Proiect-Krontech/ProiectKrontech/hardware/kicad/components/HX711_mod/HX711_module.jpg

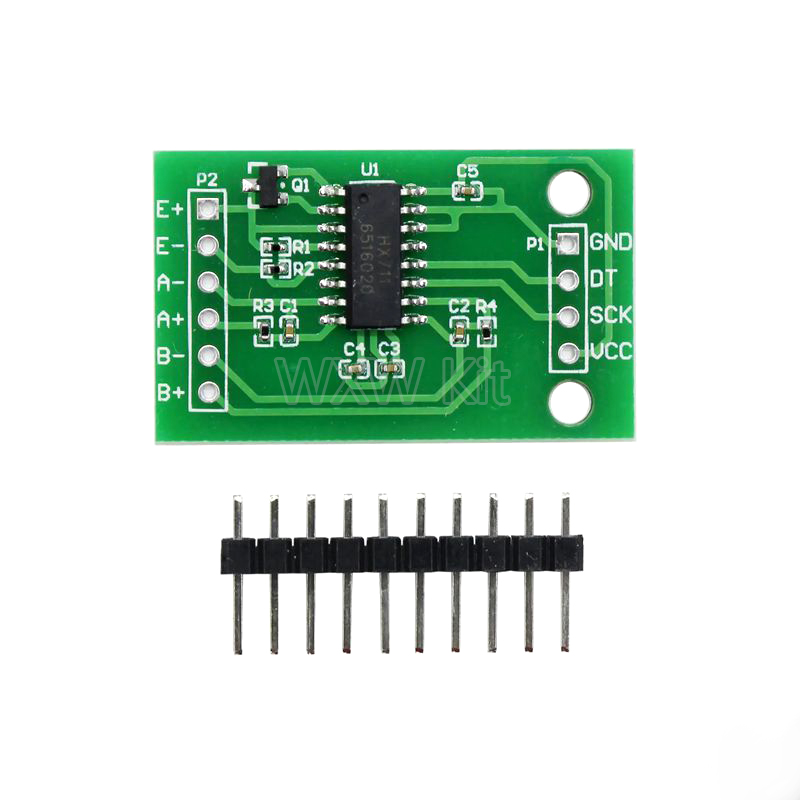
hardware/kicad/components/HX711_mod/HX711_module.jpg
