Proiect-Krontech/ProiectKrontech/docs/smart_pillow_future_3D.png

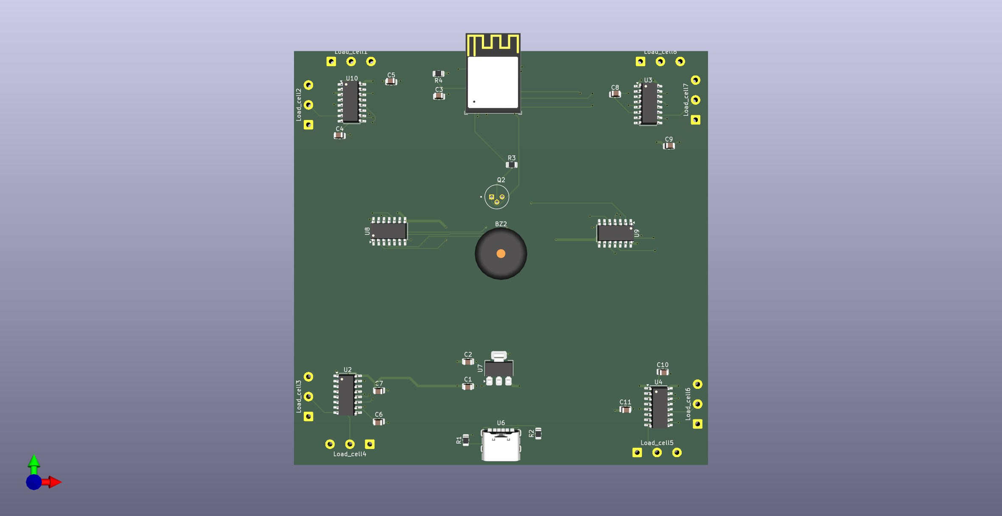
docs/smart_pillow_future_3D.png
