Proiect-Krontech/ProiectKrontech/docs/smart_pillow_future_PCB.png

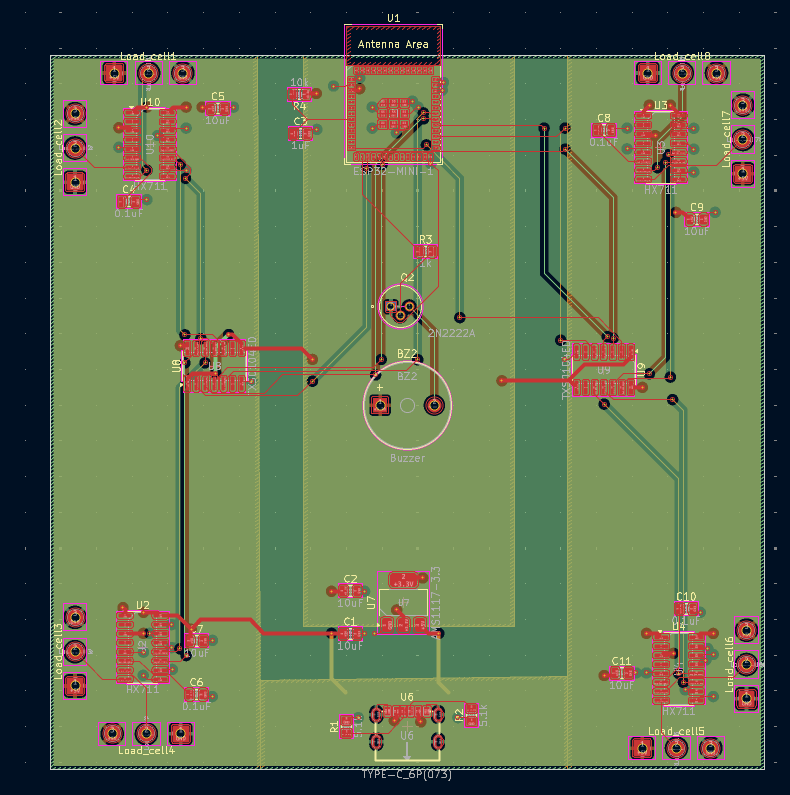
docs/smart_pillow_future_PCB.png
