Proiect-Krontech/ProiectKrontech/hardware/kicad/components/2N2222A/2N2222A.step

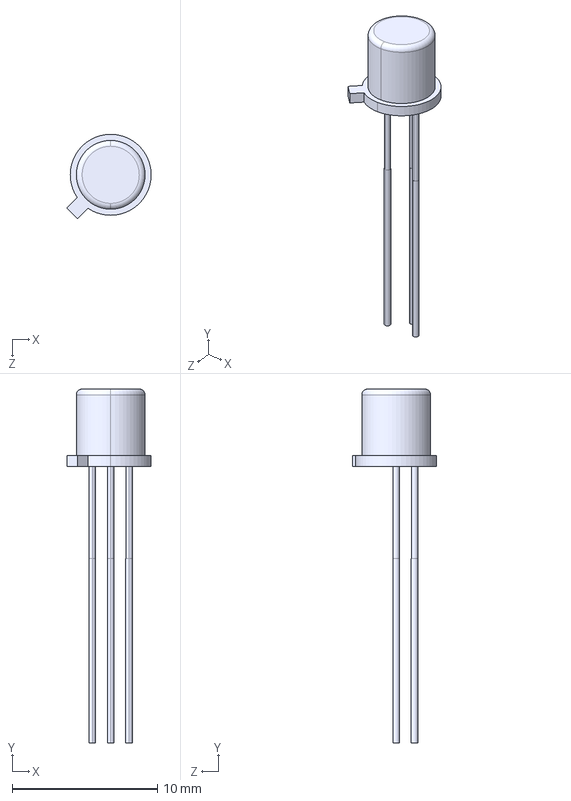
[picture p4: CAD file, 2026-05-10]
hardware/kicad/components/2N2222A/2N2222A.step
5.81 x 24.4 x 5.81 mm
