Proiect-Krontech/ProiectKrontech/docs/design_circuit.pdf

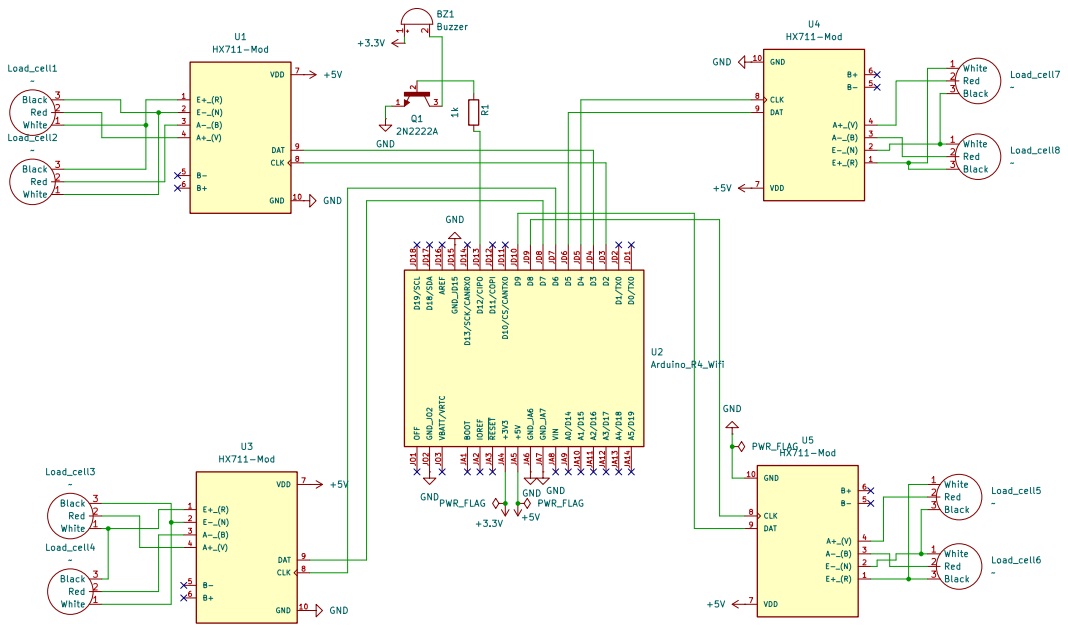
[picture p5: page 1]
