Proiect-Krontech/ProiectKrontech/docs/smart_pillow_future.pdf

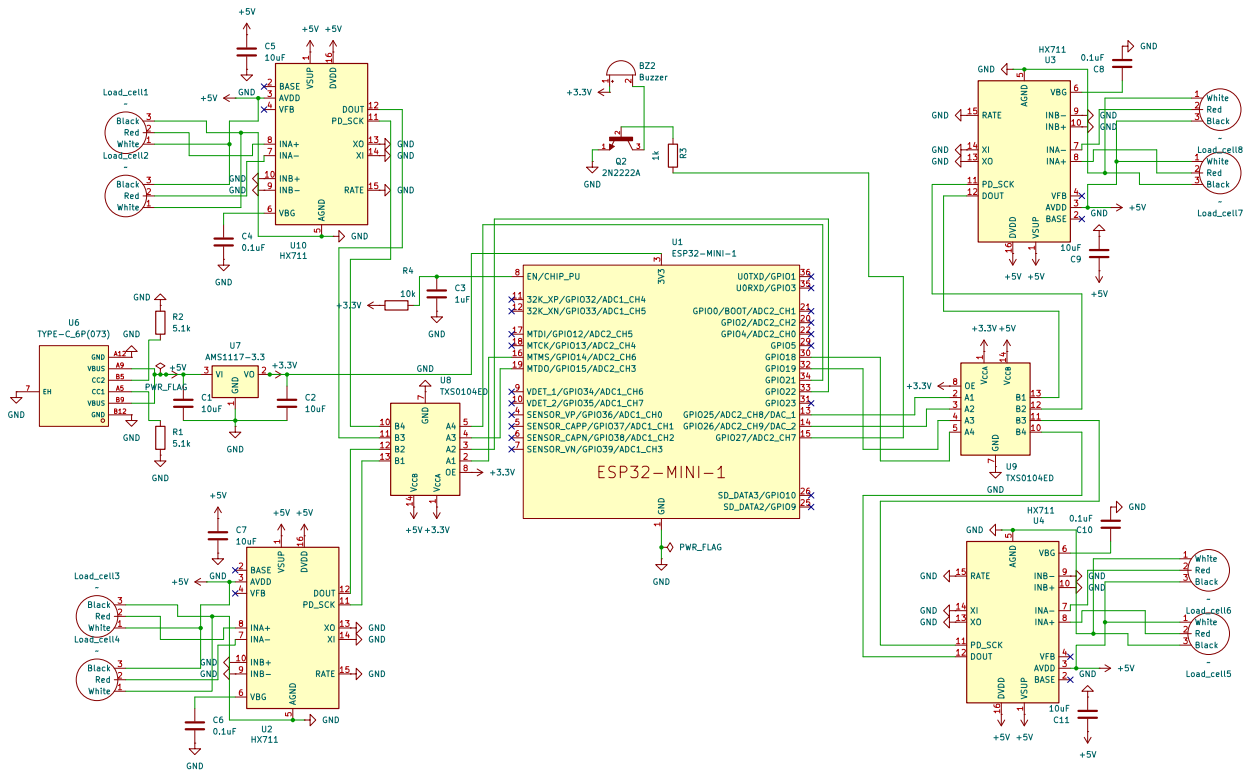
[picture p6: page 1]
