Proiect-Krontech/ProiectKrontech/hardware/future direction/smart_pillow/smart_pillow/smart_pillow.kicad_pcb

## KiCad design hardware/future direction/smart_pillow/smart_pillow/smart_pillow.kicad_pcb (2026-05-15)

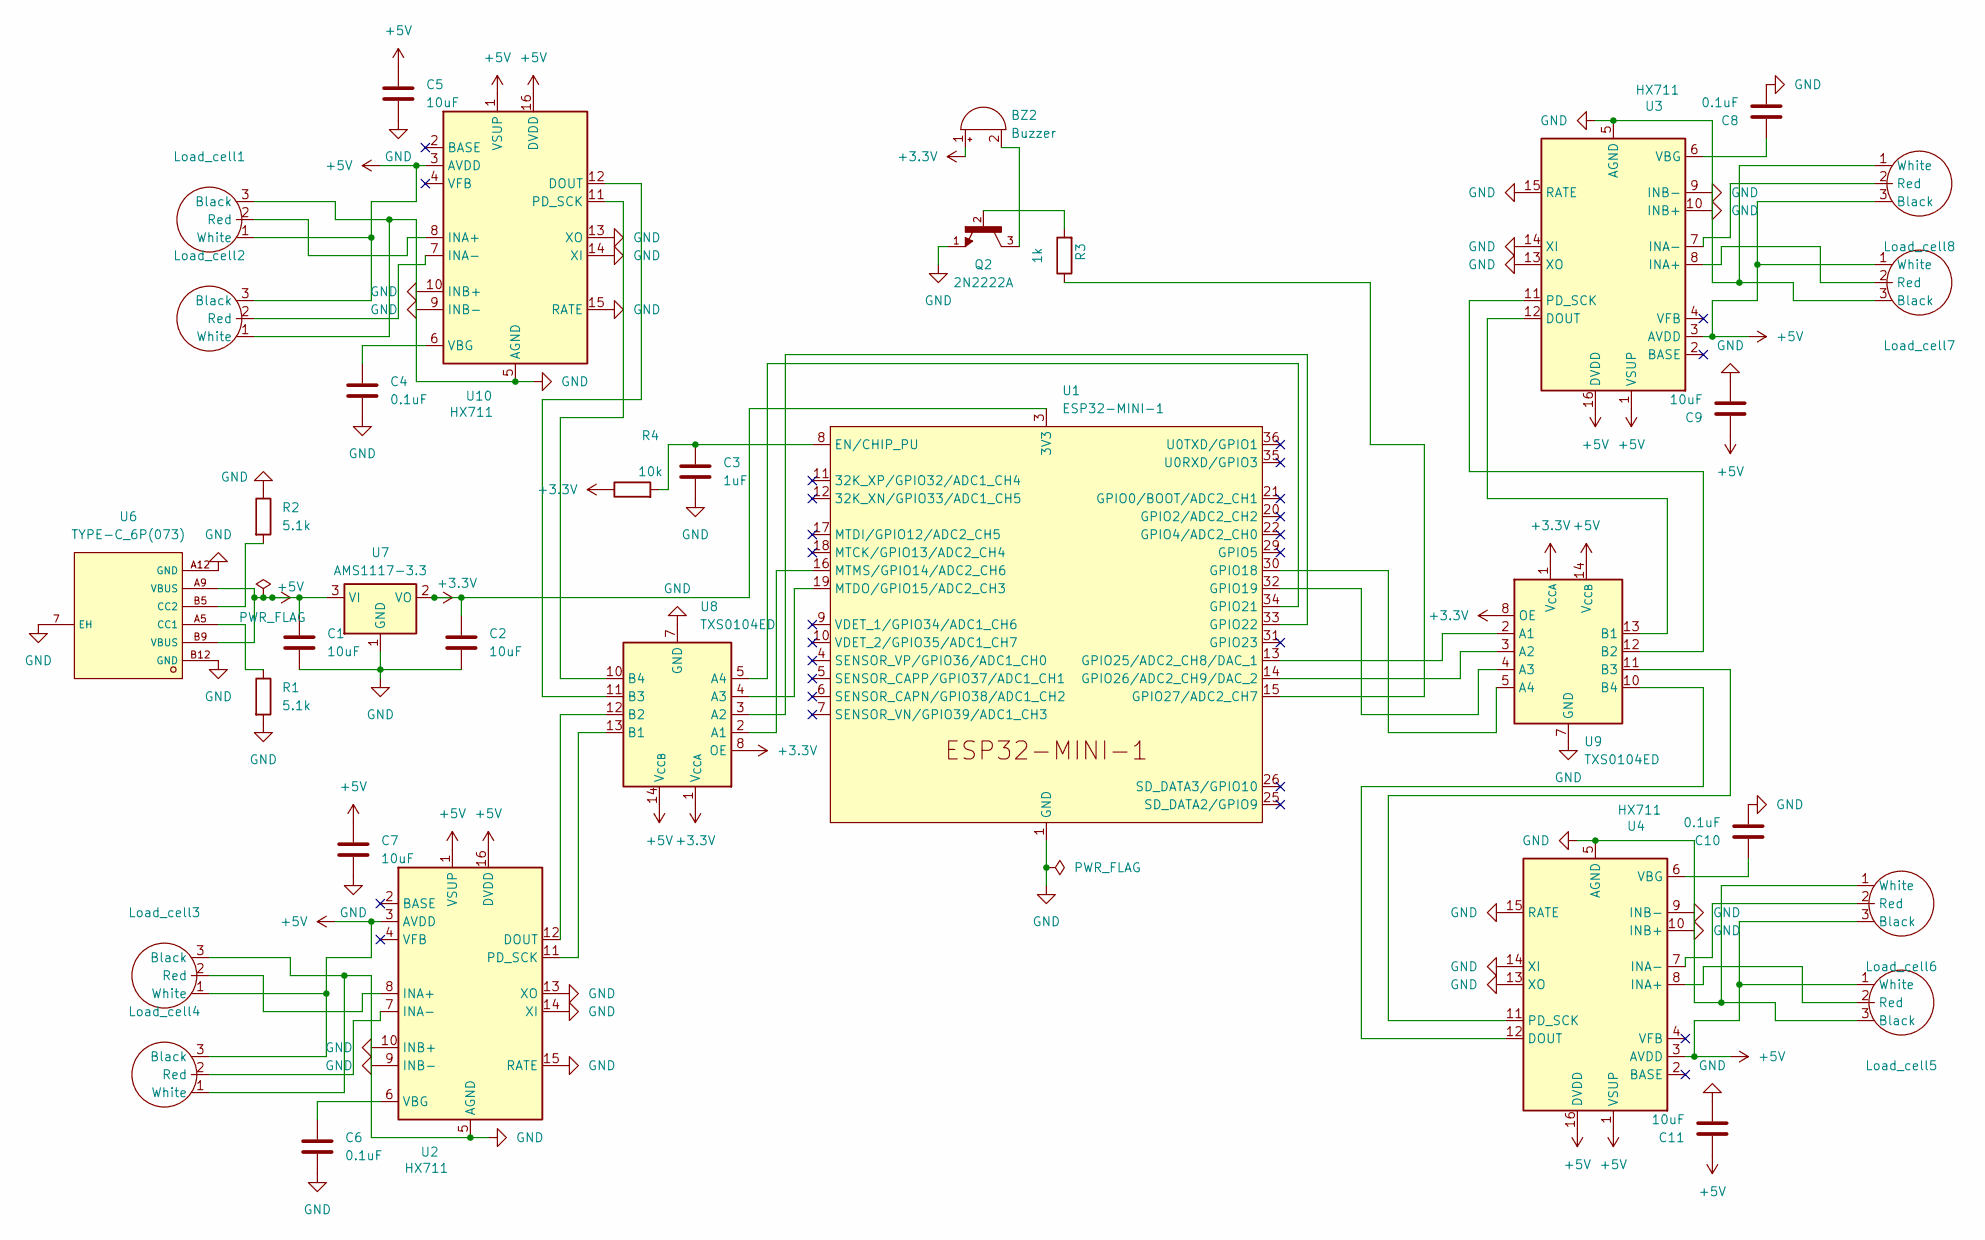
[picture p7: schematic smart_pillow.kicad_sch]

Parts:
BZ2: Buzzer; Buzzer_12x9.5RM7.6
C1, C2, C5, C7, C9, C11: 10uF; C_0805_2012Metric
C3: 1uF; C_0805_2012Metric
C4, C6, C8, C10: 0.1uF; C_0805_2012Metric
Load_cell1, Load_cell2, Load_cell3, Load_cell4, Load_cell5, Load_cell6, Load_cell7, Load_cell8: SolderWire-0.5sqmm_1x03_P4.8mm_D0.9mm_OD2.3mm
Q2: 2N2222A; TO127P584H533-3; PARTREV 2
R1, R2: 5.1k; R_0805_2012Metric
R3: 1k; R_0805_2012Metric
R4: 10k; R_0805_2012Metric
U1: ESP32-MINI-1
U2, U3, U4, U10: HX711; SOIC-16_3.9x9.9mm_P1.27mm
U6: TYPE-C_6P(073); TYPE-C-SMD_TYPE-C-6P-073; LCSC C668623
U7: AMS1117-3.3; SOT-223-3_TabPin2
U8, U9: TXS0104ED; SOIC-14_3.9x8.7mm_P1.27mm

Connections:
+3.3V: BZ2.1 (+), C2.1, R4.1, U1.3 (3V3), U7.2 (VO), U8.1 (V_{CCA}), U8.8 (OE), U9.1 (V_{CCA}), U9.8 (OE)
+5V: C1.1, C5.1, C7.1, C9.1, C11.1, Load_cell1.1 (White), Load_cell2.3 (Black), Load_cell3.1 (White), Load_cell4.3 (Black), Load_cell5.1 (White), Load_cell6.3 (Black), Load_cell7.1 (White), Load_cell8.3 (Black), U2.1 (VSUP), U2.3 (AVDD), U2.16 (DVDD), U3.1 (VSUP), U3.3 (AVDD), U3.16 (DVDD), U4.1 (VSUP), U4.3 (AVDD), U4.16 (DVDD), U6.A9 (VBUS), U6.B9 (VBUS), U7.3 (VI), U8.14 (V_{CCB}), U9.14 (V_{CCB}), U10.1 (VSUP), U10.3 (AVDD), U10.16 (DVDD)
GND: C1.2, C2.2, C3.2, C4.2, C5.2, C6.2, C7.2, C8.2, C9.2, C10.2, C11.2, Load_cell1.3 (Black), Load_cell2.1 (White), Load_cell3.3 (Black), Load_cell4.1 (White), Load_cell5.3 (Black), Load_cell6.1 (White), Load_cell7.3 (Black), Load_cell8.1 (White), Q2.1, R1.2, R2.1, U1.1 (GND), U1.2 (GND), U1.27 (GND), U1.38 (GND), U1.39 (GND), U1.40 (GND), U1.41 (GND), U1.42 (GND), U1.43 (GND), U1.44 (GND), U1.45 (GND), U1.46 (GND), U1.47 (GND), U1.48 (GND), U1.49 (GND), U1.50 (GND), U1.51 (GND), U1.52 (GND), U1.53 (GND), U1.54 (GND), U1.55 (GND), U2.5 (AGND), U2.9 (INB-), U2.10 (INB+), U2.13 (XO), U2.14 (XI), U2.15 (RATE), U3.5 (AGND), U3.9 (INB-), U3.10 (INB+), U3.13 (XO), U3.14 (XI), U3.15 (RATE), U4.5 (AGND), U4.9 (INB-), U4.10 (INB+), U4.13 (XO), U4.14 (XI), U4.15 (RATE), U6.7 (EH), U6.A12 (GND), U6.B12 (GND), U7.1 (GND), U8.7 (GND), U9.7 (GND), U10.5 (AGND), U10.9 (INB-), U10.10 (INB+), U10.13 (XO), U10.14 (XI), U10.15 (RATE)
unnamed: BZ2.2 (-), Q2.3
unnamed: Load_cell1.2 (Red), U10.8 (INA+)
unnamed: Load_cell2.2 (Red), U10.7 (INA-)
unnamed: Load_cell3.2 (Red), U2.8 (INA+)
unnamed: Load_cell4.2 (Red), U2.7 (INA-)
unnamed: Load_cell5.2 (Red), U4.8 (INA+)
unnamed: Load_cell6.2 (Red), U4.7 (INA-)
unnamed: Load_cell7.2 (Red), U3.8 (INA+)
unnamed: Load_cell8.2 (Red), U3.7 (INA-)
unnamed: Q2.2, R3.2
unnamed: C3.1, R4.2, U1.8 (EN/CHIP_PU)
unnamed: U1.30 (GPIO18), U9.5 (A4)
unnamed: U1.32 (GPIO19), U9.4 (A3)
unnamed: U1.34 (GPIO21), U8.5 (A4)
unnamed: U1.33 (GPIO22), U8.3 (A2)
unnamed: U1.13 (GPIO25/ADC2_CH8/DAC_1), U9.2 (A1)
unnamed: U1.14 (GPIO26/ADC2_CH9/DAC_2), U9.3 (A2)
unnamed: R3.1, U1.15 (GPIO27/ADC2_CH7)
unnamed: U1.19 (MTDO/GPIO15/ADC2_CH3), U8.4 (A3)
unnamed: U1.16 (MTMS/GPIO14/ADC2_CH6), U8.2 (A1)
unnamed: U2.12 (DOUT), U8.12 (B2)
unnamed: U2.11 (PD_SCK), U8.13 (B1)
unnamed: C6.1, U2.6 (VBG)
unnamed: U3.12 (DOUT), U9.13 (B1)
unnamed: U3.11 (PD_SCK), U9.12 (B2)
unnamed: C8.1, U3.6 (VBG)
unnamed: U4.12 (DOUT), U9.10 (B4)
unnamed: U4.11 (PD_SCK), U9.11 (B3)
unnamed: C10.1, U4.6 (VBG)
unnamed: R1.1, U6.A5 (CC1)
unnamed: R2.2, U6.B5 (CC2)
unnamed: U8.11 (B3), U10.12 (DOUT)
unnamed: U8.10 (B4), U10.11 (PD_SCK)
unnamed: C4.1, U10.6 (VBG)

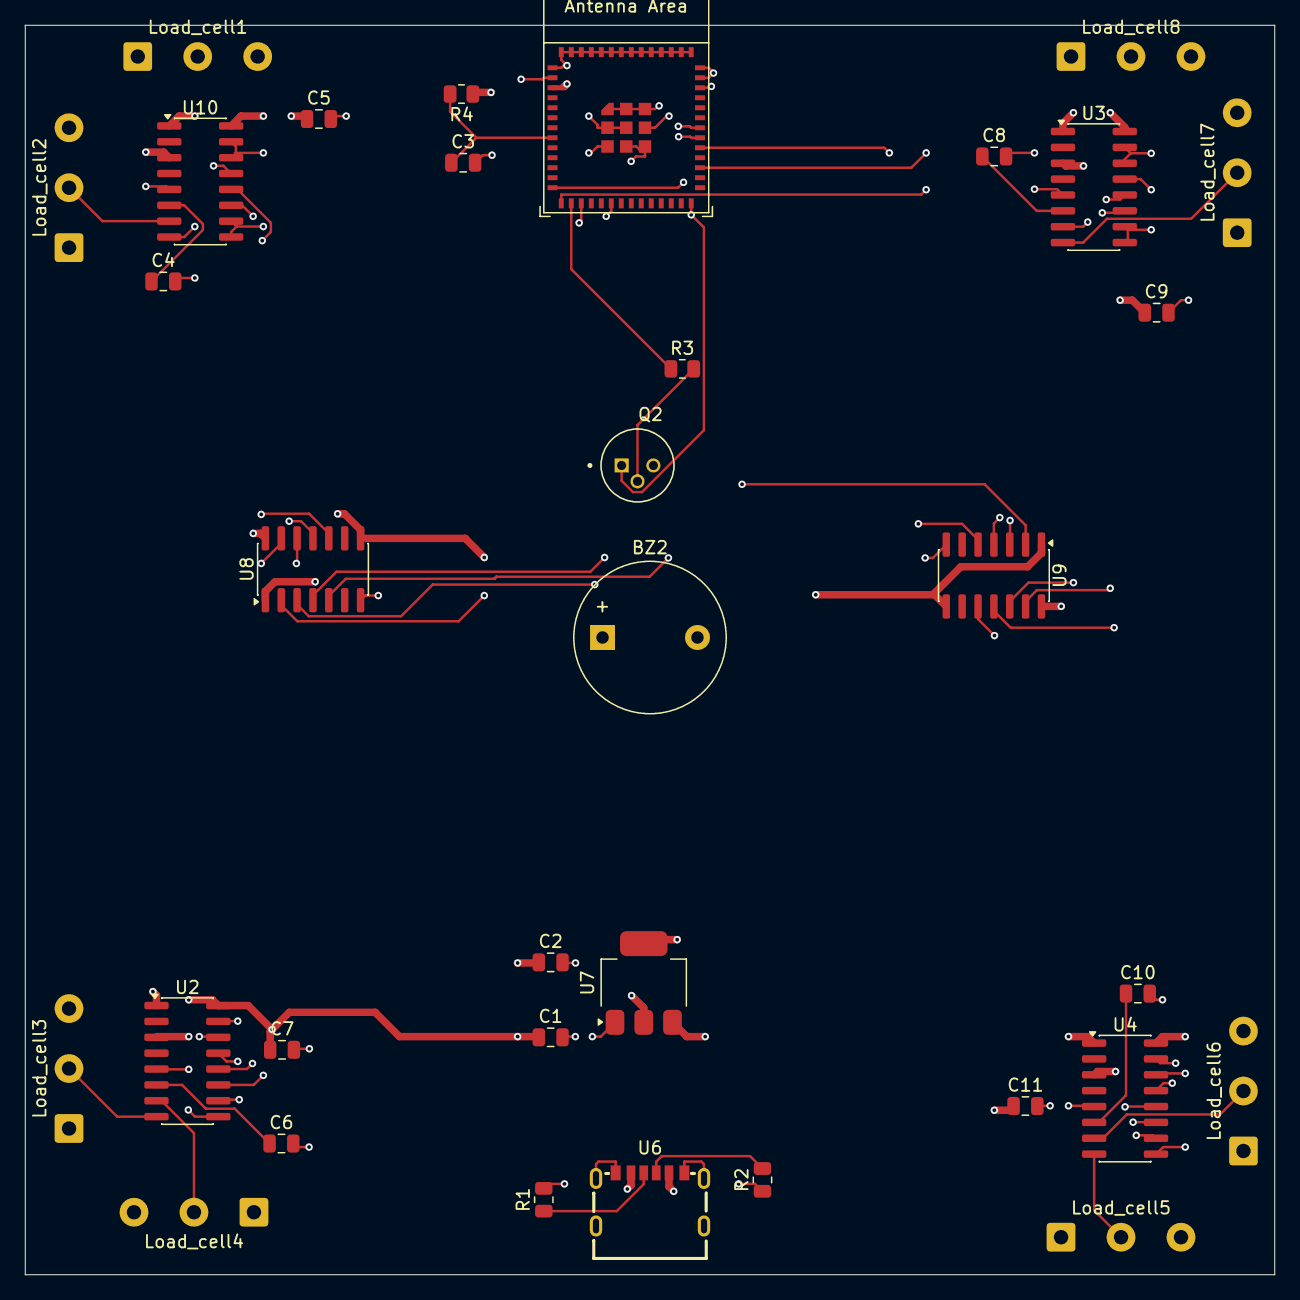
[picture p8: board hardware/future direction/smart_pillow/smart_pillow/smart_pillow.kica… from above]

Board: 4 copper layers, 100.0 x 100.0 mm, 34 parts (0 on the bottom side), 37 nets.
