Proiect-Krontech/ProiectKrontech/hardware/kicad/smart_pillow/smart_pillow.kicad_pcb

## KiCad design hardware/kicad/smart_pillow/smart_pillow.kicad_pcb (2026-05-15)

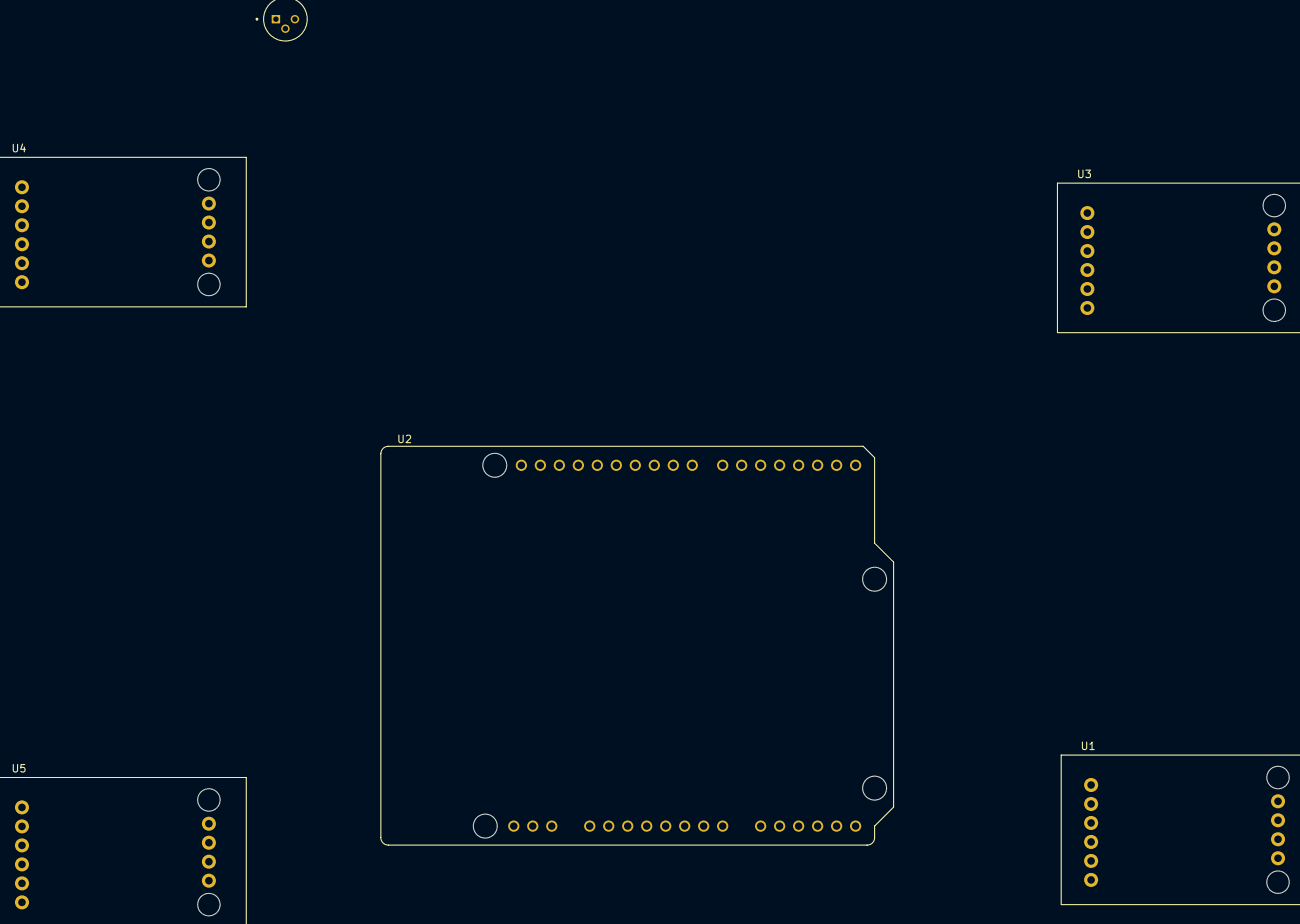
[picture p9: board hardware/kicad/smart_pillow/smart_pillow.kicad_pcb from above]

Board: 2 copper layers, 6 parts (0 on the bottom side), 10 nets, no tracks yet.

Parts:
Q1: 2N2222A; TO127P584H533-3
U1, U3, U4, U5: HX711-Mod; HX711_module
U2: Arduino_R4_Wifi; MODULE_ABX00087

Connections:
+5V: U1.7 (VDD), U2.JA5 (+5V), U3.7 (VDD), U4.7 (VDD), U5.7 (VDD)
GND: Q1.1, U1.10 (GND), U2.JA6 (GND_JA6), U2.JA7 (GND_JA7), U2.JD15 (GND_JD15), U2.JO2 (GND_JO2), U3.10 (GND), U4.10 (GND), U5.10 (GND)
unnamed: U1.8 (CLK), U2.JD3 (D2)
unnamed: U1.9 (DAT), U2.JD4 (D3)
unnamed: U2.JD5 (D4), U4.8 (CLK)
unnamed: U2.JD6 (D5), U4.9 (DAT)
unnamed: U2.JD7 (D6), U3.8 (CLK)
unnamed: U2.JD8 (D7), U3.9 (DAT)
unnamed: U2.JD9 (D8), U5.8 (CLK)
unnamed: U2.JD10 (D9), U5.9 (DAT)
