Proiect-Krontech/ProiectKrontech/(commit log)

2026-04-23 feat: reset project structure to official version
    [main.cpp]
2026-04-26 chore(firmware-arduino): add module structure and placeholder files
2026-04-30 refactor: remove accelerometer module and clean up related code
2026-05-04 feat: Add landing-component
2026-05-04 chore: update platformio config for firmware-arduino
2026-05-04 feat(hx711): add HX711 driver implementation
2026-05-04 feat(sensor-manager): integrate loadcell support
2026-05-04 Revert "Merge pull request #12 from Proiect-Krontech/feature/sensor"
    This reverts commit 64bc68e4fed0c18819c82069a388de74d6149f52, reversing
    changes made to 4fe123f43013a077d18f17973678b14c3b4f3ad3.
    [Config.hpp]
2026-05-07 refactor:remove redundant calibration delay and align main.cpp
2026-05-10 feat(hardware): add smart_pillow KiCad project and component libraries
    [2N2222A.step, smart_pillow.kicad_pcb, smart_pillow.kicad_sch]
2026-05-10 chore: add KiCad rules to gitignore
2026-05-10 docs(hardware): add circuit schematic PDF
2026-05-13 refactor: simplify SensorManager logging
2026-05-13 fix: send device status when calibration is missing
    [main.cpp]
2026-05-13 chore: update wifi, server and calibration settings
2026-05-15 test: add QA test suite (Cypress E2E + firmware unit tests) and electrical schematics
    [2N2222A.step, smart_pillow.kicad_pcb, smart_pillow.kicad_sch]
2026-05-15 docs: add PCB schematics and 3D renders
2026-05-16 Add Cypress and KiCad files to .gitignore
